MichaelEE0318/einkboard/hardware/case/stl/shell_ribbed.stl

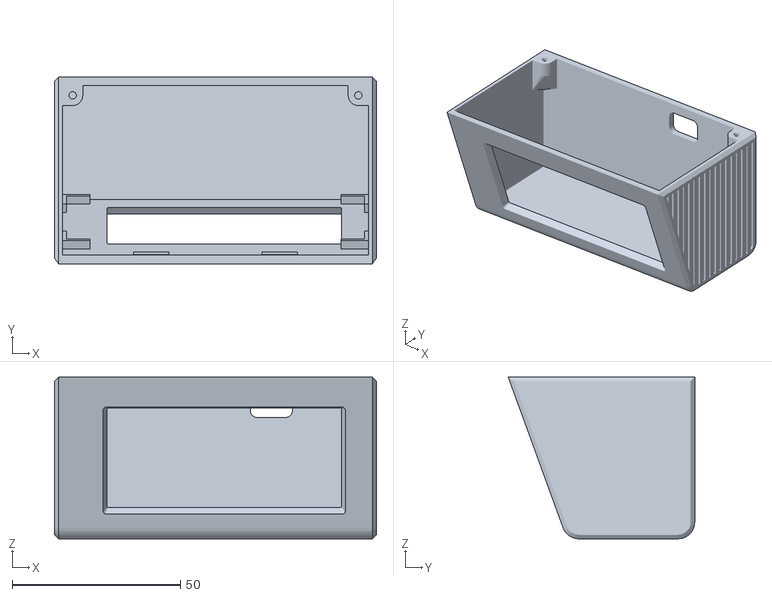
[picture p2: CAD file, 2026-11-02]
hardware/case/stl/shell_ribbed.stl
95.6 x 55.4 x 48.0
