MichaelEE0318/einkboard/hardware/case/stl/shell_retro.stl

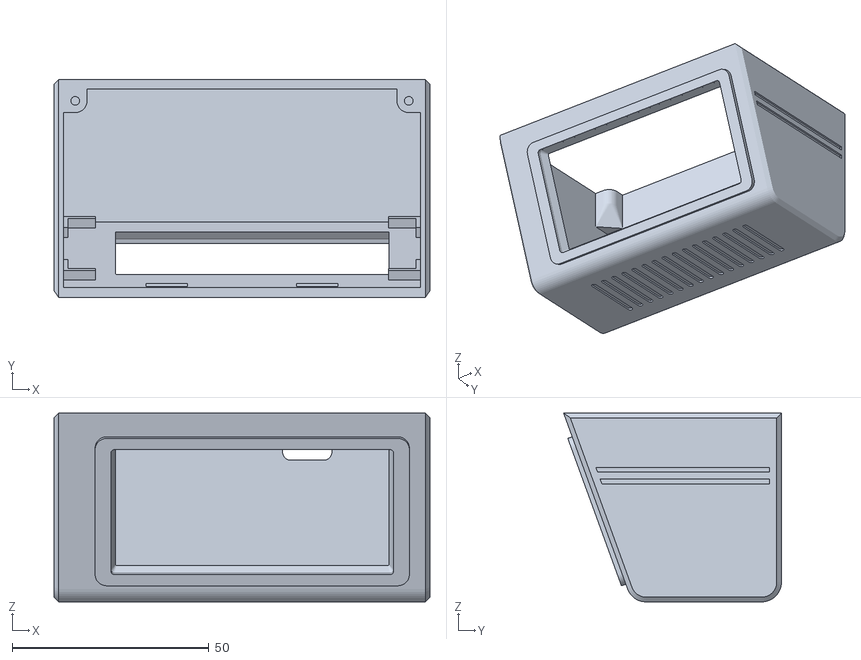
[picture p3: CAD file, 2026-11-02]
hardware/case/stl/shell_retro.stl
95.6 x 55.4 x 48.0
