MichaelEE0318/einkboard/hardware/case/stl/plate.stl

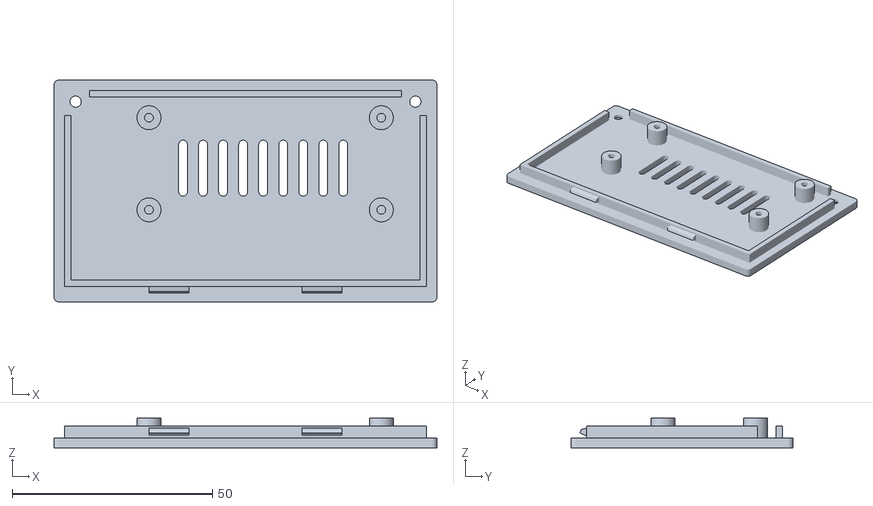
[picture p4: CAD file, 2026-11-02]
hardware/case/stl/plate.stl
95.6 x 55.4 x 7.39
