MichaelEE0318/einkboard/hardware/case/stl/eink_fit_test.stl

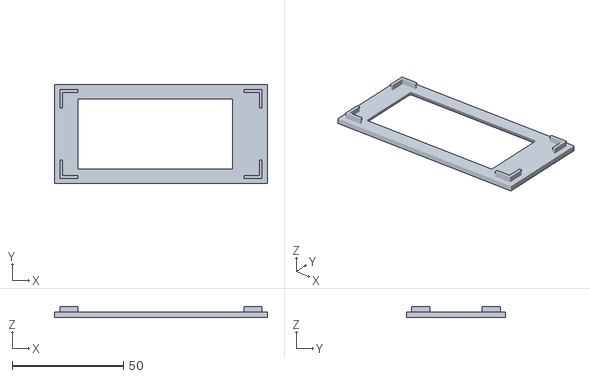
[picture p5: CAD file, 2026-11-02]
hardware/case/stl/eink_fit_test.stl
95.8 x 44.7 x 5.00
