MichaelEE0318/einkboard/hardware/case/stl/shell_clean.stl

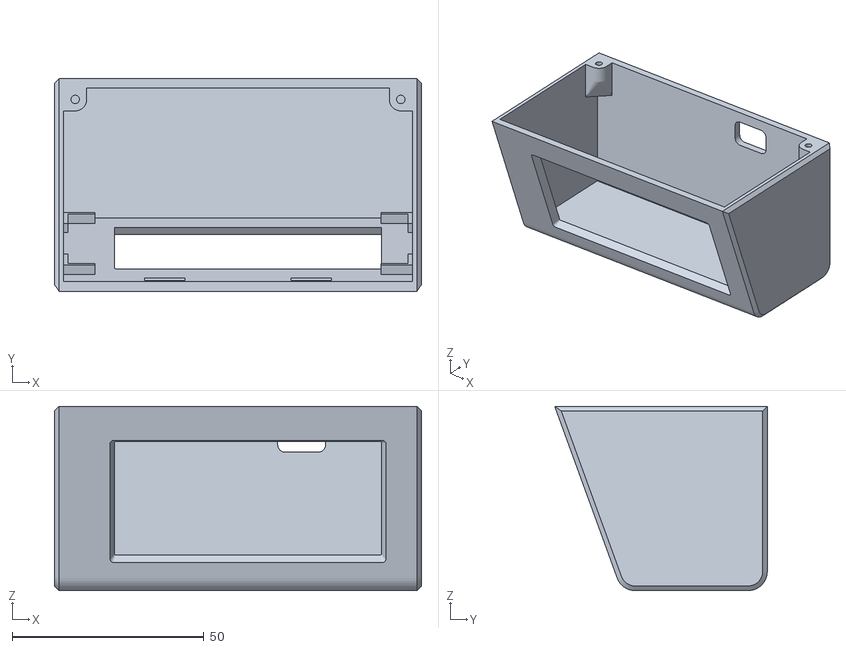
[picture p6: CAD file, 2026-11-02]
hardware/case/stl/shell_clean.stl
95.6 x 55.4 x 48.0
