MichaelEE0318/einkboard/einkboard/pages.py

"""296x128 1-bit pages. Every page is a pure function of (data, now) -> PIL image, so it can be
previewed and tested on any computer."""
import datetime as dt

from PIL import Image, ImageDraw

from . import fonts
from .sources import LIGHT

W, H = 296, 128
BLACK, WHITE = 0, 255
WEEK = "一二三四五六日"


def canvas():
    img = Image.new("1", (W, H), WHITE)
    return img, ImageDraw.Draw(img)


def cjk(size, bold=False):
    return fonts.get(size, bold=bold, cjk=True)


def num(size, bold=True):
    return fonts.get(size, bold=bold)


def fmt(v, nd=0, dash="--"):
    return dash if v is None else f"{v:,.{nd}f}"


def text_r(d, xr, y, s, font, fill=BLACK):
    d.text((xr - d.textlength(s, font=font), y), s, font=font, fill=fill)


def fit(d, s, font, width):
    """Trim with an ellipsis so CJK titles never run off the panel."""
    if d.textlength(s, font=font) <= width:
        return s
    while s and d.textlength(s + "…", font=font) > width:
        s = s[:-1]
    return s + "…"


def stale_tag(d, x, y):
    f = cjk(12, True)
    w = d.textlength("離線", font=f)
    d.rounded_rectangle([x, y, x + w + 8, y + 16], radius=4, fill=BLACK)
    d.text((x + 4, y - 1), "離線", font=f, fill=WHITE)


# ------------------------------------------------------------------ weather icons
def icon(d, kind, cx, cy, r):
    """Simple line icons drawn with primitives (no icon font needed)."""
    def sun(x, y, rr):
        d.ellipse([x - rr, y - rr, x + rr, y + rr], outline=BLACK, width=2)
        import math
        for a in range(0, 360, 45):
            c, s = math.cos(math.radians(a)), math.sin(math.radians(a))
            d.line([x + c * rr * 1.45, y + s * rr * 1.45, x + c * rr * 1.95, y + s * rr * 1.95], fill=BLACK, width=2)

    def cloud(x, y, rr, fill=WHITE):
        parts = [(x - rr * 0.55, y + rr * 0.1, rr * 0.55), (x + rr * 0.05, y - rr * 0.25, rr * 0.75),
                 (x + rr * 0.65, y + rr * 0.15, rr * 0.5)]
        for px, py, pr in parts:            # outline pass
            d.ellipse([px - pr - 2, py - pr - 2, px + pr + 2, py + pr + 2], fill=BLACK)
        d.rectangle([x - rr * 0.55, y + rr * 0.1, x + rr * 0.65, y + rr * 0.65 + 2], fill=BLACK)
        for px, py, pr in parts:            # fill pass
            d.ellipse([px - pr, py - pr, px + pr, py + pr], fill=fill)
        d.rectangle([x - rr * 0.55, y + rr * 0.1, x + rr * 0.65, y + rr * 0.65], fill=fill)

    if kind == "sun":
        sun(cx, cy, r * 0.5)
    elif kind == "partly":
        sun(cx - r * 0.3, cy - r * 0.3, r * 0.35)
        cloud(cx + r * 0.1, cy + r * 0.15, r * 0.6)
    elif kind in ("cloud", "fog"):
        cloud(cx, cy - r * 0.1, r * 0.75)
        if kind == "fog":
            for i in range(3):
                y = cy + r * 0.55 + i * 5
                d.line([cx - r * 0.7, y, cx + r * 0.7, y], fill=BLACK, width=2)
    elif kind in ("rain", "storm", "snow"):
        cloud(cx, cy - r * 0.3, r * 0.7)
        for i, dx in enumerate((-0.45, 0, 0.45)):
            x, y = cx + dx * r, cy + r * 0.5
            if kind == "snow":
                d.text((x - 4, y - 6), "*", font=num(14), fill=BLACK)
            elif kind == "storm" and i == 1:
                d.line([x + 3, y - 2, x - 3, y + 7, x + 3, y + 7, x - 2, y + 15], fill=BLACK, width=2)
            else:
                d.line([x + 2, y, x - 2, y + 9], fill=BLACK, width=2)


# ------------------------------------------------------------------ page 1: clock + weather
def page_clock(now, wx, loc_name="", stale=False):
    img, d = canvas()
    # left: clock
    hm = now.strftime("%H:%M")
    size = 56
    while size > 30 and d.textlength(hm, font=num(size)) > 146:   # 字寬依字型自動縮，不壓到右半邊
        size -= 2
    d.text((6, 26 - size * 0.58), hm, font=num(size), fill=BLACK)
    d.text((9, 60), f"{now.month}月{now.day}日  週{WEEK[now.weekday()]}", font=cjk(16, True), fill=BLACK)
    d.line([8, 86, 150, 86], fill=BLACK)
    # forecast strip (next 12 h, every 3 h)
    hours = (wx or {}).get("hours") or []
    for i, h in enumerate(hours[:4]):
        x = 8 + i * 36
        d.text((x + 3, 89), f"{h['h']:02d}時", font=cjk(10), fill=BLACK)
        d.text((x + 3, 101), f"{fmt(h['temp'])}°", font=num(12), fill=BLACK)
        d.text((x + 3, 114), f"{fmt(h['rain'])}%", font=num(10, False), fill=BLACK)

    d.line([158, 6, 158, H - 6], fill=BLACK, width=2)

    # right: weather now
    x0 = 166
    if not wx:
        d.text((x0, 50), "天氣資料載入中…", font=cjk(13), fill=BLACK)
        return img
    icon(d, wx["icon"], x0 + 22, 28, 24)
    text_r(d, W - 28, 4, f"{fmt(wx['temp'])}°", num(32))      # right-aligned, clear of the status corner
    d.text((x0, 56), fit(d, f"{loc_name} {wx['desc']}", cjk(14, True), W - x0 - 4), font=cjk(14, True), fill=BLACK)
    d.text((x0, 76), f"最高 {fmt(wx['hi'])}°  最低 {fmt(wx['lo'])}°", font=cjk(12), fill=BLACK)
    d.text((x0, 93), f"體感 {fmt(wx['feels'])}°  濕度 {fmt(wx['rh'])}%", font=cjk(12), fill=BLACK)
    # rain bar
    rain = wx.get("rain") or 0
    d.text((x0, 110), "降雨", font=cjk(11), fill=BLACK)
    bx0, bx1 = x0 + 28, W - 34
    d.rectangle([bx0, 113, bx1, 122], outline=BLACK)
    d.rectangle([bx0, 113, bx0 + (bx1 - bx0) * min(rain, 100) / 100, 122], fill=BLACK)
    text_r(d, W - 4, 109, f"{fmt(rain)}%", num(12))
    return img


# ------------------------------------------------------------------ page 2: Taipower
def page_power(now, pw, stale=False):
    img, d = canvas()
    d.text((6, 1), "台電供電資訊", font=cjk(15, True), fill=BLACK)
    if not pw:
        d.text((6, 50), "台電資料載入中…", font=cjk(14), fill=BLACK)
        return img
    pub = pw.get("publish") or ""
    text_r(d, W - 28, 4, (pub[-5:] if len(pub) >= 5 else pub) + " 更新", cjk(10))

    # left: today's peak reserve forecast + light
    zh, note = LIGHT.get(pw["light"], ("--", ""))
    d.text((6, 24), "今日尖峰備轉容量率", font=cjk(11), fill=BLACK)
    d.text((4, 34), f"{fmt(pw['fore_rate'], 1)}", font=num(40), fill=BLACK)
    rx = 6 + d.textlength(fmt(pw["fore_rate"], 1), font=num(40))
    d.text((rx + 2, 55), "%", font=num(16), fill=BLACK)
    # light badge: filled = needs attention (non-green)
    lf = cjk(13, True)
    bw = d.textlength(f"{zh} {note}", font=lf) + 12
    alert = pw["light"] not in ("green", None)
    d.rounded_rectangle([6, 84, 6 + bw, 102], radius=9, fill=BLACK if alert else WHITE, outline=BLACK, width=2)
    d.text((12, 83), f"{zh} {note}", font=lf, fill=WHITE if alert else BLACK)
    resv = pw.get("fore_resv")
    sub = f"備轉 {fmt(resv)} 萬瓩" + (f"  {pw['fore_hours']}" if pw.get("fore_hours") else "")
    d.text((6, 107), fit(d, sub, cjk(10), 146), font=cjk(10), fill=BLACK)

    d.line([158, 24, 158, H - 6], fill=BLACK, width=2)

    # right: real-time
    x0 = 166
    d.text((x0, 24), "目前用電", font=cjk(11), fill=BLACK)
    d.text((x0, 36), fmt(pw["load"], 0), font=num(24), fill=BLACK)
    text_r(d, W - 6, 46, "萬瓩", cjk(11))
    d.text((x0, 66), f"供電能力 {fmt(pw['cap'], 0)} 萬瓩", font=cjk(11), fill=BLACK)
    util = pw.get("util")
    d.text((x0, 84), "使用率", font=cjk(11), fill=BLACK)
    text_r(d, W - 6, 82, f"{fmt(util, 1)}%", num(14))
    bx0, bx1 = x0, W - 6
    d.rectangle([bx0, 102, bx1, 112], outline=BLACK)
    if util is not None:
        d.rectangle([bx0, 102, bx0 + (bx1 - bx0) * min(util, 100) / 100, 112], fill=BLACK)
    for t in (90, 94):                 # 參考刻度：使用率 90% / 94% ≈ 備轉 10% / 6%
        tx = bx0 + (bx1 - bx0) * t / 100
        d.polygon([(tx - 3, 97), (tx + 3, 97), (tx, 101)], fill=BLACK)
    if pw.get("yday_rate") is not None:
        d.text((x0, 115), f"昨日尖峰備轉 {fmt(pw['yday_rate'], 1)}%", font=cjk(9), fill=BLACK)
    return img


# ------------------------------------------------------------------ page 3: stocks + FX
FX_NAME = {"USD": "美元", "JPY": "日圓", "VND": "越南盾", "EUR": "歐元", "CNY": "人民幣", "HKD": "港幣",
           "KRW": "韓元", "GBP": "英鎊", "AUD": "澳幣", "SGD": "新幣", "THB": "泰銖"}


def chg_abs_str(v):
    """Size of the move without sign: 1173 / 20 / 4.2 / 0.65 (no thousands comma: keeps a 4-digit index
    move narrow enough for the larger font)."""
    if v is None:
        return "--"
    a = abs(v)
    return f"{a:.0f}" if a >= 100 else f"{a:.2f}".rstrip("0").rstrip(".")


def price_str(v):
    if v is None:
        return "--"
    if v >= 1000:
        return f"{v:,.0f}"
    return f"{v:,.2f}".rstrip("0").rstrip(".")      # 412.5 / 189.85 / 23.1（ETF 跳動單位 0.05）


def fx_str(code, rate):
    """TWD per unit; tiny currencies (VND, KRW...) are shown per 1,000 / 10,000 units."""
    if rate is None:
        return code, "--"
    if rate < 0.01:
        return f"{code}/萬", f"{rate * 10000:.2f}"
    if rate < 0.1:
        return f"{code}/千", f"{rate * 1000:.2f}"
    return code, f"{rate:.4f}" if rate < 1 else f"{rate:.2f}"


def sparkline(d, pts, x0, y0, x1, y1, prev=None):
    """Today's prices (minute_of_day, price) between 09:00 and 13:30; dotted line = previous close."""
    if not pts or len(pts) < 2 or pts[-1][0] - pts[0][0] < 15:
        return                                  # under 15 min of data (e.g. just restarted): skip, it looks broken
    lo = min(p for _, p in pts)
    hi = max(p for _, p in pts)
    if prev:
        lo, hi = min(lo, prev), max(hi, prev)
    if hi - lo < 1e-9:
        hi = lo + 1
    t0, t1 = 9 * 60, 13 * 60 + 30
    xy = lambda m, p: (x0 + (x1 - x0) * (min(max(m, t0), t1) - t0) / (t1 - t0), y1 - (y1 - y0) * (p - lo) / (hi - lo))
    if prev:
        py = xy(t0, prev)[1]
        for x in range(int(x0), int(x1), 3):
            d.point([x, py], fill=BLACK)
    d.line([xy(m, p) for m, p in pts], fill=BLACK, width=1)


def page_market(now, mk, stale=False):
    img, d = canvas()
    d.text((6, 1), "台股．匯率", font=cjk(15, True), fill=BLACK)
    if not mk:
        d.text((6, 50), "行情資料載入中…", font=cjk(14), fill=BLACK)
        return img
    quotes = list(mk["quotes"].values())
    t = max((q.get("time") or "" for q in quotes), default="")
    src = mk.get("src", "mis")
    if mk.get("open"):
        status = f"盤中 {t[:5]}"
    elif src == "close" or (quotes and all(q.get("date") for q in quotes)):
        day = max((q.get("date") or "" for q in quotes), default="")
        status = f"收盤 {int(day[5:7])}/{int(day[8:10])}" if len(day) == 10 else "收盤"
    else:
        status = "收盤" if quotes else ""
    if status:
        f = cjk(11, True)
        w = d.textlength(status, font=f)
        if mk.get("open"):
            d.rounded_rectangle([W - w - 38, 3, W - 28, 18], radius=7, fill=BLACK)
            d.text((W - w - 33, 2), status, font=f, fill=WHITE)
        else:
            text_r(d, W - 30, 3, status, f)
    d.line([6, 21, W - 6, 21], fill=BLACK)

    rows = quotes[:4]
    fx = [(c, r) for c, r in (mk.get("fx") or {}).items()][:3]
    area = (92 if fx else H - 2) - 24
    rh = min(24, area // max(1, len(rows)))
    # change box: "▼1,173" left + "2.53%" right; one font size for every row (the largest that fits all)
    bx0, bx1 = W - 82, W - 4                          # 78 px: "▼1173  2.53%" fits at size 10
    labels = []
    for q in rows:
        pct, chg = q.get("pct"), q.get("chg")
        arrow = "▲" if (pct or 0) > 0 else "▼" if (pct or 0) < 0 else ""
        labels.append((f"{arrow}{chg_abs_str(chg)}", "--" if pct is None else f"{abs(pct):.2f}%"))
    fsize = 10
    for size in ((11, 10, 9, 8) if rh >= 21 else (10, 9, 8)):
        f = cjk(size, True)
        if all(d.textlength(a, font=f) + d.textlength(b, font=f) + 5 <= bx1 - bx0 - 6 for a, b in labels):
            fsize = size
            break
    fbox = cjk(fsize, True)
    y = 24
    for q, (s1, s2) in zip(rows, labels):
        name = fit(d, q["name"] or q["code"], cjk(13, True), 72)
        d.text((6, y - 1), name, font=cjk(13, True), fill=BLACK)
        d.text((6 + d.textlength(name, font=cjk(13, True)) + 3, y + 3), q["code"], font=num(9, False), fill=BLACK)
        sparkline(d, (mk.get("history") or {}).get(q["code"]), 110, y + 2, 146, y + rh - 5, q.get("prev"))
        text_r(d, bx0 - 5, y, price_str(q["price"]), num(14))
        up = (q.get("pct") or 0) > 0
        by1 = y + rh - 3
        if up:                             # 漲：實心（台灣紅色的位置）
            d.rounded_rectangle([bx0, y, bx1, by1], radius=3, fill=BLACK)
        else:                              # 跌 / 平：空心
            d.rounded_rectangle([bx0, y, bx1, by1], radius=3, outline=BLACK)
        fg = WHITE if up else BLACK
        l, t, r, b = d.textbbox((0, 0), "▼0", font=fbox)
        ty = (y + by1) / 2 - (t + b) / 2
        d.text((bx0 + 3, ty), s1, font=fbox, fill=fg)
        text_r(d, bx1 - 3, ty, s2, fbox, fill=fg)
        y += rh
    if not rows:
        d.text((6, 40), "在 config.yaml 的 market.stocks 加股票代號", font=cjk(12), fill=BLACK)

    if fx:
        d.line([6, 94, W - 6, 94], fill=BLACK)
        cw = (W - 12) / len(fx)
        for i, (code, rate) in enumerate(fx):
            x = 6 + i * cw
            label, val = fx_str(code, rate)
            d.text((x, 97), FX_NAME.get(code, code), font=cjk(10), fill=BLACK)
            d.text((x + d.textlength(FX_NAME.get(code, code), font=cjk(10)) + 3, 97), label, font=cjk(9), fill=BLACK)
            d.text((x, 109), val, font=num(14), fill=BLACK)
            if i:
                d.line([x - 5, 98, x - 5, 124], fill=BLACK)
    return img


# ------------------------------------------------------------------ status signs (manual: 出差中 / 下班了 / 暫離)
STATUS_KINDS = {"trip": "出差中", "off": "下班了", "away": "暫離", "custom": "字卡"}


def _icon_plane(d, cx, cy, s=1.0):
    """Side-view airliner, nose to the right."""
    P = lambda pts: [(cx + x * s, cy + y * s) for x, y in pts]
    d.rounded_rectangle([cx - 34 * s, cy - 5 * s, cx + 30 * s, cy + 5 * s], radius=5 * s, fill=BLACK)   # fuselage
    d.polygon(P([(36, 0), (28, -5), (28, 5)]), fill=BLACK)                                              # nose
    d.polygon(P([(-6, 2), (8, 2), (-10, 30), (-20, 30)]), fill=BLACK)                                   # near wing
    d.polygon(P([(-2, -2), (8, -2), (-8, -20), (-16, -20)]), fill=BLACK)                                # far wing
    d.polygon(P([(-34, -2), (-24, -2), (-34, -20), (-40, -20)]), fill=BLACK)                            # tail fin
    for i in range(5):                                                                                   # windows
        x = cx + (-20 + i * 9) * s
        d.rectangle([x, cy - 2 * s, x + 4 * s, cy], fill=WHITE)


def _icon_moon(d, cx, cy, r=26):
    d.ellipse([cx - r, cy - r, cx + r, cy + r], fill=BLACK)
    d.ellipse([cx - r + 14, cy - r - 6, cx + r + 14, cy + r - 6], fill=WHITE)                          # carve crescent
    for sx, sy, k in ((cx + 24, cy - 22, 4), (cx + 30, cy + 8, 3), (cx + 8, cy + 26, 2)):               # stars
        d.line([sx - k, sy, sx + k, sy], fill=BLACK, width=2)
        d.line([sx, sy - k, sx, sy + k], fill=BLACK, width=2)


def _icon_cup(d, cx, cy):
    d.rounded_rectangle([cx - 22, cy - 10, cx + 14, cy + 26], radius=6, fill=BLACK)                    # cup
    d.ellipse([cx + 6, cy - 4, cx + 30, cy + 18], outline=BLACK, width=5)                              # handle
    d.rectangle([cx - 30, cy + 28, cx + 22, cy + 32], fill=BLACK)                                      # saucer
    for x in (cx - 12, cx - 3, cx + 6):                                                                 # steam
        d.arc([x - 4, cy - 34, x + 4, cy - 22], 90, 270, fill=BLACK, width=2)
        d.arc([x - 4, cy - 24, x + 4, cy - 12], 270, 90, fill=BLACK, width=2)


# ------------------------------------------------------------------ 字卡圖示（左邊 98 px 的格子，中心約 (48, 64)）
def _icon_people(d, cx, cy):                    # 開會：兩個人＋桌子
    for dx, r in ((-14, 9), (14, 9)):
        d.ellipse([cx + dx - r, cy - 30, cx + dx + r, cy - 30 + 2 * r], fill=BLACK)
        d.pieslice([cx + dx - 16, cy - 8, cx + dx + 16, cy + 24], 180, 360, fill=BLACK)
    d.rectangle([cx - 36, cy + 10, cx + 36, cy + 15], fill=BLACK)
    d.rectangle([cx - 30, cy + 15, cx - 26, cy + 32], fill=BLACK)
    d.rectangle([cx + 26, cy + 15, cx + 30, cy + 32], fill=BLACK)


def _icon_phone(d, cx, cy):                     # 電話中／講電話
    d.rounded_rectangle([cx - 16, cy - 32, cx + 16, cy + 32], radius=6, fill=BLACK)
    d.rectangle([cx - 11, cy - 23, cx + 11, cy + 18], fill=WHITE)
    d.ellipse([cx - 3, cy + 22, cx + 3, cy + 28], fill=WHITE)
    for r in (8, 15):                           # sound waves
        d.arc([cx + 18 - r, cy - 30 - r, cx + 18 + r, cy - 30 + r], 300, 30, fill=BLACK, width=3)


def _icon_clock(d, cx, cy):                     # 稍等／時間
    d.ellipse([cx - 32, cy - 32, cx + 32, cy + 32], outline=BLACK, width=5)
    for k in range(12):
        import math
        a = math.radians(k * 30)
        r1 = 23 if k % 3 else 20
        d.line([cx + r1 * math.sin(a), cy - r1 * math.cos(a), cx + 26 * math.sin(a), cy - 26 * math.cos(a)],
               fill=BLACK, width=2)
    d.line([cx, cy, cx, cy - 18], fill=BLACK, width=4)
    d.line([cx, cy, cx + 13, cy + 7], fill=BLACK, width=4)
    d.ellipse([cx - 4, cy - 4, cx + 4, cy + 4], fill=BLACK)


def _icon_house(d, cx, cy):                     # 在家工作
    d.polygon([(cx - 38, cy - 2), (cx, cy - 36), (cx + 38, cy - 2)], fill=BLACK)
    d.rectangle([cx - 28, cy - 4, cx + 28, cy + 32], fill=BLACK)
    d.rectangle([cx - 8, cy + 10, cx + 8, cy + 32], fill=WHITE)
    d.rectangle([cx + 14, cy + 4, cx + 22, cy + 12], fill=WHITE)
    d.rectangle([cx + 18, cy - 32, cx + 26, cy - 16], fill=BLACK)   # chimney


def _icon_bowl(d, cx, cy):                      # 用餐／午休
    d.chord([cx - 34, cy - 22, cx + 34, cy + 36], 0, 180, fill=BLACK)
    d.rectangle([cx - 14, cy + 30, cx + 14, cy + 34], fill=BLACK)
    d.line([cx + 4, cy - 34, cx + 30, cy + 4], fill=BLACK, width=3)   # chopsticks
    d.line([cx + 14, cy - 36, cx + 36, cy], fill=BLACK, width=3)
    for x in (cx - 16, cx - 4):                 # steam
        d.arc([x - 4, cy - 26, x + 4, cy - 14], 90, 270, fill=BLACK, width=2)
        d.arc([x - 4, cy - 16, x + 4, cy - 4], 270, 90, fill=BLACK, width=2)


def _icon_car(d, cx, cy):                       # 外出／開車
    d.polygon([(cx - 22, cy - 8), (cx - 12, cy - 26), (cx + 14, cy - 26), (cx + 26, cy - 8)], fill=BLACK)
    d.polygon([(cx - 15, cy - 9), (cx - 9, cy - 21), (cx - 1, cy - 21), (cx - 1, cy - 9)], fill=WHITE)
    d.polygon([(cx + 3, cy - 9), (cx + 3, cy - 21), (cx + 12, cy - 21), (cx + 19, cy - 9)], fill=WHITE)
    d.rounded_rectangle([cx - 38, cy - 10, cx + 38, cy + 14], radius=7, fill=BLACK)
    for x in (cx - 22, cx + 22):
        d.ellipse([x - 11, cy + 2, x + 11, cy + 24], fill=BLACK)
        d.ellipse([x - 5, cy + 8, x + 5, cy + 18], fill=WHITE)
    d.rectangle([cx + 30, cy - 4, cx + 36, cy + 1], fill=WHITE)   # headlight


def _icon_helmet(d, cx, cy):                    # 案場／工地
    d.pieslice([cx - 32, cy - 30, cx + 32, cy + 30], 180, 360, fill=BLACK)
    d.rounded_rectangle([cx - 42, cy - 2, cx + 42, cy + 8], radius=4, fill=BLACK)
    d.rectangle([cx - 4, cy - 30, cx + 4, cy - 2], fill=WHITE)   # ridge
    d.rectangle([cx - 2, cy - 28, cx + 2, cy - 4], fill=BLACK)


def _icon_bolt(d, cx, cy):                      # 電力／儲能
    d.polygon([(cx + 8, cy - 38), (cx - 22, cy + 6), (cx - 2, cy + 6), (cx - 10, cy + 38),
               (cx + 22, cy - 8), (cx + 2, cy - 8)], fill=BLACK)


def _icon_battery(d, cx, cy):                   # 充電／儲能系統
    d.rounded_rectangle([cx - 20, cy - 30, cx + 20, cy + 34], radius=5, outline=BLACK, width=5)
    d.rectangle([cx - 9, cy - 37, cx + 9, cy - 30], fill=BLACK)
    for i in range(3):
        y = cy + 22 - i * 16
        d.rectangle([cx - 12, y - 6, cx + 12, y + 6], fill=BLACK)


def _icon_doc(d, cx, cy):                       # 文件／專心寫東西
    d.polygon([(cx - 24, cy - 34), (cx + 12, cy - 34), (cx + 26, cy - 20), (cx + 26, cy + 34), (cx - 24, cy + 34)],
              outline=BLACK, width=4)
    d.polygon([(cx + 12, cy - 34), (cx + 12, cy - 20), (cx + 26, cy - 20)], fill=BLACK)
    for i in range(4):
        y = cy - 12 + i * 11
        d.line([cx - 14, y, cx + (16 if i < 3 else 2), y], fill=BLACK, width=3)


def _icon_cross(d, cx, cy):                     # 看醫生／請假
    d.rounded_rectangle([cx - 32, cy - 32, cx + 32, cy + 32], radius=10, fill=BLACK)
    d.rectangle([cx - 7, cy - 22, cx + 7, cy + 22], fill=WHITE)
    d.rectangle([cx - 22, cy - 7, cx + 22, cy + 7], fill=WHITE)


def _icon_check(d, cx, cy):                     # 完成／OK
    d.ellipse([cx - 34, cy - 34, cx + 34, cy + 34], fill=BLACK)
    d.line([(cx - 18, cy + 1), (cx - 5, cy + 15), (cx + 20, cy - 13)], fill=WHITE, width=9, joint="curve")


def _icon_bang(d, cx, cy):                      # 注意／請勿打擾
    d.polygon([(cx, cy - 36), (cx + 38, cy + 30), (cx - 38, cy + 30)], fill=BLACK)
    d.rectangle([cx - 4, cy - 14, cx + 4, cy + 12], fill=WHITE)
    d.rectangle([cx - 4, cy + 17, cx + 4, cy + 24], fill=WHITE)


def _icon_heart(d, cx, cy):
    d.ellipse([cx - 34, cy - 28, cx + 2, cy + 6], fill=BLACK)
    d.ellipse([cx - 2, cy - 28, cx + 34, cy + 6], fill=BLACK)
    d.polygon([(cx - 33, cy - 6), (cx + 33, cy - 6), (cx, cy + 32)], fill=BLACK)


ICONS = {   # key: (中文名, 畫法)；左格中心 (48, 64)
    "meeting": ("開會", lambda d: _icon_people(d, 48, 66)),
    "phone": ("電話", lambda d: _icon_phone(d, 46, 66)),
    "clock": ("時鐘", lambda d: _icon_clock(d, 48, 64)),
    "cup": ("咖啡", lambda d: _icon_cup(d, 46, 64)),
    "bowl": ("用餐", lambda d: _icon_bowl(d, 46, 62)),
    "house": ("在家", lambda d: _icon_house(d, 48, 64)),
    "car": ("外出", lambda d: _icon_car(d, 48, 62)),
    "plane": ("飛機", lambda d: _icon_plane(d, 50, 58, 1.0)),
    "helmet": ("案場", lambda d: _icon_helmet(d, 48, 70)),
    "bolt": ("閃電", lambda d: _icon_bolt(d, 48, 64)),
    "battery": ("電池", lambda d: _icon_battery(d, 48, 64)),
    "doc": ("文件", lambda d: _icon_doc(d, 48, 64)),
    "cross": ("醫療", lambda d: _icon_cross(d, 48, 64)),
    "moon": ("月亮", lambda d: _icon_moon(d, 48, 62)),
    "check": ("完成", lambda d: _icon_check(d, 48, 64)),
    "bang": ("注意", lambda d: _icon_bang(d, 48, 62)),
    "heart": ("愛心", lambda d: _icon_heart(d, 48, 64)),
}
ICON_BOX = (6, 8, 92, H - 8)                   # 自訂上傳圖示的可用範圍（86×112）


def _status_frame(d, title, icon):
    d.rectangle([0, 0, W - 1, H - 1], outline=BLACK, width=2)
    d.line([98, 10, 98, H - 10], fill=BLACK, width=1)
    icon()
    d.text((108, 6), title, font=cjk(30, True), fill=BLACK)


def _date_zh(day):
    return f"{day.month}/{day.day}（{WEEK[day.weekday()]}）"


def page_trip(now, info):
    """出差中: where, back on which day (with a countdown), how to reach me."""
    img, d = canvas()
    _status_frame(d, "出差中", lambda: _icon_plane(d, 50, 58, 1.0))
    place = (info.get("place") or "").strip()
    if place:
        d.text((110, 46), fit(d, place, cjk(16, True), W - 118), font=cjk(16, True), fill=BLACK)
    back = info.get("back")
    y = 72
    if back:
        try:
            day = dt.date.fromisoformat(back)
            left = (day - now.date()).days
            tag = "今天回來" if left == 0 else (f"還有 {left} 天" if left > 0 else "已過預定回程")
            f = cjk(13, True)
            w = d.textlength(tag, font=f)
            d.rounded_rectangle([W - w - 18, y + 1, W - 8, y + 19], radius=9, fill=BLACK)
            d.text((W - w - 13, y + 1), tag, font=f, fill=WHITE)
            d.text((110, y), fit(d, f"{_date_zh(day)} 回來", cjk(13), W - w - 132), font=cjk(13), fill=BLACK)
        except ValueError:
            pass
    note = (info.get("note") or "").strip()
    if note:
        d.text((110, H - 22), fit(d, note, cjk(11), W - 118), font=cjk(11), fill=BLACK)
    return img


def _next_workday_label(now):
    """When I'm back, seen from `now`: Mon–Thu evening -> 明天, Fri/Sat -> 下週一, Sun -> 明天;
    before 06:00 on a weekday it's still the same working day -> 今天."""
    wd = now.weekday()
    if now.hour < 6 and wd <= 4:
        return "今天"
    if wd in (4, 5):
        return "下週一"
    return "明天"


def page_off(now, info, wx=None):
    """下班了: when I'm back, and tomorrow's weather."""
    img, d = canvas()
    _status_frame(d, "下班了", lambda: _icon_moon(d, 48, 62))
    back = (info.get("back") or "09:00").strip()
    d.text((110, 48), f"{_next_workday_label(now)} {back} 見", font=cjk(18, True), fill=BLACK)
    note = (info.get("note") or "").strip()
    if note:
        d.text((110, 76), fit(d, note, cjk(12), W - 118), font=cjk(12), fill=BLACK)
    t = (wx or {}).get("tomorrow")
    if t:
        d.line([108, H - 26, W - 8, H - 26], fill=BLACK)
        d.text((110, H - 23), f"明天 {t['desc']}  {fmt(t['lo'])}°～{fmt(t['hi'])}°  降雨 {fmt(t.get('rain'))}%",
               font=cjk(11), fill=BLACK)
    return img


def page_away(now, info):
    """暫離: back at what time + an optional note, centred in the right panel. Static on purpose."""
    img, d = canvas()
    d.rectangle([0, 0, W - 1, H - 1], outline=BLACK, width=2)
    d.line([98, 10, 98, H - 10], fill=BLACK, width=1)
    _icon_cup(d, 46, 64)
    back = (info.get("back") or "").strip()
    note = (info.get("note") or "").strip()
    lines = [("暫離", cjk(30, True)), (f"預計 {back} 回來" if back else "馬上回來", cjk(18, True))]
    if note:
        lines.append((fit(d, note, cjk(14), W - 118), cjk(14)))
    gap = 6
    boxes = [d.textbbox((0, 0), t, font=f) for t, f in lines]
    total = sum(b[3] - b[1] for b in boxes) + gap * (len(lines) - 1)
    x_mid, y = (99 + W - 2) / 2, (H - total) / 2               # centre of the right panel
    for (t, f), b in zip(lines, boxes):
        d.text((x_mid - (b[2] - b[0]) / 2 - b[0], y - b[1]), t, font=f, fill=BLACK)
        y += b[3] - b[1] + gap
    return img


# ------------------------------------------------------------------ 字卡（完全手填）
CARD_MAX_LINES, CARD_MAX_CHARS = 5, 80


def _wrap(d, line, font, width):
    """Break one line to fit `width` (CJK: any character; Latin: prefer spaces)."""
    out, cur = [], ""
    for ch in line:
        if d.textlength(cur + ch, font=font) <= width or not cur:
            cur += ch
            continue
        cut = cur.rfind(" ")
        if cut > 0 and cur[cut + 1:].isascii() and ch != " ":
            out.append(cur[:cut]); cur = cur[cut + 1:] + ch
        else:
            out.append(cur.rstrip()); cur = ch.lstrip()
    out.append(cur)
    return out


def card_layout(d, text, title=False, bold=False, box=(8, 16, W - 8, H - 6)):
    """Largest font that fits the box. Lines are kept as typed when possible; only wrap when the
    unwrapped text would end up smaller than 18 px. Returns [(text, font, height)], gap."""
    lines = [ln.strip() for ln in text.split("\n")]
    while lines and not lines[-1]:
        lines.pop()
    while lines and not lines[0]:
        lines.pop(0)
    if not lines:
        return [], 0
    bw, bh = box[2] - box[0], box[3] - box[1]

    def build(size, wrap):
        rows = []
        for i, ln in enumerate(lines):
            big = title and i == 0 and len(lines) > 1
            f = cjk(min(96, round(size * 1.45)) if big else size, bold or big)
            parts = _wrap(d, ln, f, bw) if wrap else [ln]
            for part in parts:
                b = d.textbbox((0, 0), "國Ag", font=f)
                rows.append((part, f, b[3] - b[1]))
        gap = max(2, size // 5)
        total = sum(r[2] for r in rows) + gap * (len(rows) - 1)
        widest = max(d.textlength(r[0], font=r[1]) for r in rows)
        return rows, gap, total <= bh and widest <= bw

    for wrap in (False, True):
        for size in range(72, 9, -1):
            rows, gap, ok = build(size, wrap)
            if ok and (wrap or size >= 18):
                return rows, gap
    return build(10, True)[:2]


def missing_glyphs(text, bold=False):
    """Characters the panel font can't draw (emoji etc.) — they would show as an empty box."""
    def shape(f, ch):
        im = Image.new("1", (32, 32), 0)
        ImageDraw.Draw(im).text((4, 2), ch, font=f, fill=1)
        return im.tobytes()

    out = []
    for f in {cjk(20, bold), cjk(20, True)}:
        tofu = shape(f, "\uFFFF")
        for ch in set(text):
            if not ch.isspace() and ch not in out and shape(f, ch) == tofu:
                out.append(ch)
    return sorted(out)


def decode_icon(b64):
    """Uploaded icon (base64 PNG/JPEG) -> grayscale image that fits the left panel, or None."""
    import base64
    import io
    try:
        im = Image.open(io.BytesIO(base64.b64decode(b64.split(",")[-1], validate=True)))
        im.load()
    except Exception:
        return None
    if im.mode in ("RGBA", "LA", "P"):
        im = im.convert("RGBA")
        bg = Image.new("RGBA", im.size, (255, 255, 255, 255))
        im = Image.alpha_composite(bg, im)
    im = im.convert("L")
    bw, bh = ICON_BOX[2] - ICON_BOX[0], ICON_BOX[3] - ICON_BOX[1]
    im.thumbnail((bw, bh), Image.LANCZOS)
    return im


def icon_bitmap(gray, dither=False, threshold=128):
    """Grayscale -> 1-bit: plain threshold for logos/line art, Floyd–Steinberg for photos."""
    from PIL import ImageOps
    g = ImageOps.autocontrast(gray, cutoff=1)
    if dither:
        return g.convert("1")
    return g.point(lambda v: 255 if v >= threshold else 0).convert("1", dither=Image.Dither.NONE)


def _draw_card_icon(img, d, info):
    key = info.get("icon") or ""
    if key == "upload" and info.get("icon_png"):
        g = decode_icon(info["icon_png"])
        if g is None:
            return
        bmp = icon_bitmap(g, bool(info.get("icon_dither")))
        x0, y0, x1, y1 = ICON_BOX
        img.paste(bmp, (int(x0 + (x1 - x0 - bmp.width) / 2), int(y0 + (y1 - y0 - bmp.height) / 2)))
    elif key in ICONS:
        ICONS[key][1](d)


def _draw_rows(d, rows, gap, box, left, ink=BLACK):
    total = sum(r[2] for r in rows) + gap * (len(rows) - 1)
    y = box[1] + (box[3] - box[1] - total) / 2
    for t, f, h in rows:
        top = d.textbbox((0, 0), "國Ag", font=f)[1]
        w = d.textlength(t, font=f)
        x = box[0] if left else (box[0] + box[2] - w) / 2
        d.text((x, y - top), t, font=f, fill=ink)
        y += h + gap


def page_card(now, info):
    """字卡。layout=sign：跟其他狀態牌一樣（左邊圖示、右邊文字）；layout=free：整面都是字。
    選項：置中／靠左、第一行放大、粗體、外框（free）、黑底白字。"""
    img, d = canvas()
    text = info.get("text") or ""
    left = info.get("align") == "left"
    if info.get("layout") == "sign":
        d.rectangle([0, 0, W - 1, H - 1], outline=BLACK, width=2)
        d.line([98, 10, 98, H - 10], fill=BLACK, width=1)
        _draw_card_icon(img, d, info)
        box = (106, 16, W - 8, H - 6)                     # top 16: keep clear of the Wi-Fi icon
        rows, gap = card_layout(d, text, info.get("title", True), bool(info.get("bold")), box)
        if not rows:
            d.text(((box[0] + box[2]) / 2, H / 2), "（還沒有輸入文字）", font=cjk(12), fill=BLACK, anchor="mm")
        _draw_rows(d, rows, gap, box, left)
    else:
        if info.get("border"):
            d.rectangle([2, 2, W - 3, H - 3], outline=BLACK, width=2)
        box = (12, 16, W - 12, H - 10) if info.get("border") else (8, 16, W - 8, H - 6)
        rows, gap = card_layout(d, text, bool(info.get("title")), bool(info.get("bold")), box)
        if not rows:
            d.text((W / 2, H / 2), "（還沒有輸入文字）", font=cjk(14), fill=BLACK, anchor="mm")
        _draw_rows(d, rows, gap, box, left)
    if info.get("invert"):
        from PIL import ImageOps
        img = ImageOps.invert(img.convert("L")).convert("1")
    return img


def page_status(now, info, wx=None):
    kind = info.get("kind")
    if kind == "custom":
        return page_card(now, info)
    if kind == "trip":
        return page_trip(now, info)
    if kind == "off":
        return page_off(now, info, wx)
    return page_away(now, info)


# ------------------------------------------------------------------ Wi-Fi indicator (every page, top-right)
def draw_wifi(img, bars, connected=True, internet=True, stale=False):
    """14x12 px Wi-Fi fan in the top-right corner.
    bars 1-3 = signal; '!' = Wi-Fi up but no internet; slash = not connected."""
    d = ImageDraw.Draw(img)
    x0, y0 = W - 18, 2                      # icon box: x0..x0+14, y0..y0+12
    cx, cy = x0 + 7, y0 + 11                # fan centre (bottom middle)
    d.rectangle([x0 - 1, y0 - 1, x0 + 15, y0 + 13], fill=WHITE)
    d.ellipse([cx - 1, cy - 2, cx + 1, cy], fill=BLACK)                       # dot
    shown = bars if connected else 3
    for i, r in enumerate((4, 7, 10), start=1):
        box = [cx - r, cy - r, cx + r, cy + r]
        if i <= shown:
            d.arc(box, 225, 315, fill=BLACK, width=2)
        else:                                   # missing bar: thin dotted hint so the icon keeps its shape
            for a in range(228, 315, 14):
                import math
                px, py = cx + r * math.cos(math.radians(a)), cy + r * math.sin(math.radians(a))
                d.point([px, py], fill=BLACK)
    if not connected:                           # slash through the fan
        d.line([x0, y0 + 1, x0 + 14, y0 + 12], fill=WHITE, width=4)
        d.line([x0, y0 + 1, x0 + 14, y0 + 12], fill=BLACK, width=2)
    elif not internet or stale:                 # '!' to the left of the fan: no internet / this page's data is old
        d.rectangle([x0 - 6, y0 - 1, x0 - 2, y0 + 13], fill=WHITE)
        d.rectangle([x0 - 5, y0, x0 - 3, y0 + 7], fill=BLACK)
        d.rectangle([x0 - 5, y0 + 10, x0 - 3, y0 + 12], fill=BLACK)
    return img


# ------------------------------------------------------------------ night / boot
def page_night(now, wx=None):
    img, d = canvas()
    d.text((W // 2 - 40, 18), "晚安", font=cjk(36, True), fill=BLACK)
    msg = f"{now.month}/{now.day} 週{WEEK[now.weekday()]}"
    if wx and wx.get("tomorrow"):
        t = wx["tomorrow"]
        msg += f"   明天 {t['desc']} {fmt(t['lo'])}°~{fmt(t['hi'])}°"
    d.text((W // 2 - d.textlength(msg, font=cjk(13)) / 2, 76), msg, font=cjk(13), fill=BLACK)
    d.text((W // 2 - d.textlength("夜間暫停更新", font=cjk(10)) / 2, 104), "夜間暫停更新", font=cjk(10), fill=BLACK)
    return img


# ------------------------------------------------------------------ Wi-Fi 開箱設定
def draw_qr(img, text, x, y, size):
    """QR Code，盡量用整數倍放大（1-bit 才會銳利）。沒有 qrcode 套件就畫提示框。"""
    d = ImageDraw.Draw(img)
    try:
        import qrcode
        q = qrcode.QRCode(border=0, error_correction=qrcode.constants.ERROR_CORRECT_L)
        q.add_data(text)
        q.make(fit=True)
        m = q.get_matrix()
    except Exception:
        d.rectangle([x, y, x + size, y + size], outline=BLACK, width=2)
        d.text((x + size / 2, y + size / 2), "QR", font=num(20), fill=BLACK, anchor="mm")
        return
    n = len(m)
    k = max(1, size // n)
    ox, oy = x + (size - n * k) // 2, y + (size - n * k) // 2
    for r, row in enumerate(m):
        for c, v in enumerate(row):
            if v:
                d.rectangle([ox + c * k, oy + r * k, ox + c * k + k - 1, oy + r * k + k - 1], fill=BLACK)


def page_setup(ap, message="", url="http://10.42.0.1"):
    """熱點模式：左邊 QR（掃了就連上熱點），右邊步驟。"""
    from .wifi import wifi_qr_text
    img, d = canvas()
    draw_qr(img, wifi_qr_text(ap["ssid"], ap["password"]), 6, 6, 116)
    x = 128
    msg = message or "請設定 Wi-Fi"
    size = next((z for z in (14, 13, 12, 11) if d.textlength(msg, font=cjk(z, True)) <= W - x - 4), 11)
    d.text((x, 4 + (14 - size)), fit(d, msg, cjk(size, True), W - x - 4), font=cjk(size, True), fill=BLACK)
    d.line([x, 24, W - 6, 24], fill=BLACK)
    steps = ["① 手機相機掃左邊 QR", "② 連上後會自動跳出設定頁", "③ 選 Wi-Fi、輸入密碼"]
    for i, t in enumerate(steps):
        d.text((x, 28 + i * 17), t, font=cjk(12), fill=BLACK)
    d.text((x, 82), "沒跳出來就開", font=cjk(10), fill=BLACK)
    d.text((x + 62, 82), url.replace("http://", ""), font=num(10, False), fill=BLACK)
    for y, label, val in ((96, "熱點", ap["ssid"]), (111, "密碼", ap["password"])):
        d.text((x, y), label, font=cjk(11), fill=BLACK)
        d.text((x + 28, y + 1), val, font=num(11), fill=BLACK)
    return img


def page_connecting(ssid):
    img, d = canvas()
    d.text((W / 2, 46), "正在連線…", font=cjk(22, True), fill=BLACK, anchor="mm")
    d.text((W / 2, 80), fit(d, ssid, cjk(16), W - 20), font=cjk(16), fill=BLACK, anchor="mm")
    return img


def page_connected(ssid, ip="", port=None):
    img, d = canvas()
    d.text((8, 8), "✓ Wi-Fi 已連線", font=cjk(20, True), fill=BLACK)
    d.text((8, 40), fit(d, ssid, cjk(14), W - 16), font=cjk(14), fill=BLACK)
    if ip and port:
        url = f"http://{ip}:{port}"
        draw_qr(img, url, W - 74, 54, 68)
        d.text((8, 72), "設定網頁（同一個 Wi-Fi 下打開）", font=cjk(11), fill=BLACK)
        d.text((8, 90), url, font=num(13), fill=BLACK)
    return img


def page_boot(ip="", port=None):
    img, d = canvas()
    d.text((8, 14), "電子紙看板 啟動中", font=cjk(20, True), fill=BLACK)
    d.text((8, 48), "正在連線取得天氣、台電、股價匯率…", font=cjk(12), fill=BLACK)
    if ip and port:
        d.text((8, 78), "設定網頁", font=cjk(11, True), fill=BLACK)
        d.text((8, 94), f"http://{ip}:{port}", font=num(15), fill=BLACK)
    elif ip:
        d.text((8, 90), f"IP {ip}", font=num(14), fill=BLACK)
    return img
