MichaelEE0318/einkboard/(commit log)

2026-10-30 einkboard: e-paper desk board for Pi Zero 2W
    Three rotating pages on a 2.9" e-paper (clock + weather, Taipower supply,
    TW stocks + FX), night mode, partial refresh, three-tier market fallback
    (MIS -> official close -> disk cache), and support for the 7-pin Heltec
    module without a RST pin.
    Claude-Session: https://claude.ai/code/session_017q85aDhjE7pAPKPWYUFAaG
2026-10-30 Add Heltec 2.9" SSD1680 driver using the panel's built-in waveform
    Waveshare's epd2in9_V2 loads a LUT tuned for Waveshare glass; on the Heltec
    DEPG0290 panel that gave inverted colours, heavy ghosting and broken partial
    refresh. heltec290.py follows Heltec's own init (soft reset, OTP waveform),
    full refresh 0x22=0xF7, partial 0x22=0xFF with 0x26 as the previous image.
    Default driver is now heltec290; eink.invert added as an escape hatch.
    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
    [config.py, display.py, einktest.py, heltec290.py]
2026-10-30 Heltec driver: real partial refresh (GxEPD2 LUT + 0xCC), full refresh only on the hour
    The panel has no usable OTP partial waveform, so 0x22=0xFF fell back to a
    flashing full update. Load GxEPD2_290_BS's partial LUT (0x32) and refresh
    with 0xCC, power off with 0x83 afterwards; reload the LUT after every full
    refresh. full_refresh_every now defaults to 0 (full refresh only at :00).
    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
2026-10-30 Heltec driver: don't cut partial refresh short; print BUSY diagnostics
    BUSY rises a few ms after 0x20; polling immediately saw "idle" and the
    following power-off command aborted the partial update. Wait 20 ms before
    polling and fall back to the datasheet time if BUSY never rises. einktest
    now prints each refresh's duration and whether BUSY toggled.
    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
    [einktest.py, heltec290.py]
2026-10-30 Heltec driver: selectable partial modes + `einktest --modes` to pick one
    Partial refresh with the SSD1680 (S800) LUT ran 3 s with no visible change
    on Michael's panel, which points at the older S75A (SSD1675A) generation.
    Add partial_mode: gx_cc (S800 LUT), otp_c4 (Heltec S75A method: 0x74/0x7E,
    0xB1 load, 0xC4 refresh), otp_ff (built-in mode 2). einktest --modes tries
    each, asks what the panel did, and prints the config line to use.
    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
2026-10-30 Heltec S75A (SSD1675A): 70-byte partial LUT modes to stop the flashing
    otp_c4 works on Michael's panel but uses the built-in full waveform, so it
    flashes. Add lut_cc / lut_c4 / lut_strong: the same partial voltage pattern
    as GxEPD2's, in the 70-byte SSD1675A layout. einktest --modes now tries
    these first and also asks whether the text is crisp.
    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
2026-10-30 Taipower: merge the split records in d006020
    The open-data JSON puts one snapshot into four records (now / today's
    forecast / yesterday / supply capacity); only the first was being read,
    so reserve rate, capacity and the light were blank. Test uses the exact
    response captured on the Pi.
    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
2026-10-30 einktest --ghost: compare 6 partial-waveform strengths / page-change strategies
    Adds lut_tp / lut_rp (partial LUT frames and repeats) and
    page_change_whitewash (old page -> white -> new page) to the config, and a
    guided test that full-refreshes a dense page, partial-switches to another,
    asks for a ghost score and prints the best settings.
    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
2026-10-30 Market: short names for index codes (t00 加權指數, o00 櫃買指數)
    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
    [sources.py]
2026-10-30 Market page: fit % boxes for 4 rows, hide sparkline under 15 min, full refresh after boot
    - Percentage box and font scale with row height; text is vertically centred
    - Sparkline needs at least 15 minutes of history (right after a restart it
    looked like a broken stub)
    - Boot screen -> first page counts as a page change, so the boot text no
    longer ghosts under the first page
    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
    [main.py, pages.py]
2026-10-30 Market page: show the price change (▼1,173) next to the %, auto-fit font
    Option C from the mock-ups: one box per row with the move on the left and
    the percentage on the right. The font is chosen once per page — the largest
    size (11/10/9/8) at which every row fits — so a 4-digit index move shrinks
    all rows together instead of overlapping.
    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
2026-10-30 Settings web page: live controls, preview, status and config editor
    - http://<pi>:8080 (stdlib http.server, no new dependencies); URL shown on
    the boot screen
    - Next / previous / go to page / pause rotation / full refresh / refetch:
    queued to the main loop, which now wakes immediately instead of sleeping
    to the next minute
    - Live preview of the panel image and per-source status with errors
    - Config editor with server-side validation; saves to config.yaml (backup
    in .bak, unedited keys kept) and restarts via exit code 75 so systemd's
    Restart=on-failure brings it back with the new settings
    Claude-Session: https://claude.ai/code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
    [config.py, main.py, pages.py, web.py]
2026-10-30 Status signs: 出差中 / 下班了 / 暫離, held until "回到輪播"
    - Three sign pages (plane / moon / cup icons drawn with primitives):
    trip shows place, return date with a day countdown and contact note;
    off shows "明天/下週一 09:00 見" plus tomorrow's weather; away shows the
    expected return time and minutes away (partial refresh, no flash)
    - A sign overrides rotation and night mode and is saved to
    cache_dir/sign.json so it survives reboots; flipping pages or
    "回到輪播" takes it down
    - Settings page: 狀態牌 card with per-type fields and validation
    Claude-Session: https://claude.ai/code/session_017q85aDhjE7p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
    [main.py, pages.py, web.py]
2026-10-30 Wi-Fi indicator on every page (bars / no internet / disconnected)
    - Reads link quality from /proc/net/wireless (no network traffic), maps it
    to 1-3 bars with hysteresis so a wavering signal doesn't keep redrawing
    - "!" when Wi-Fi is up but no data source has succeeded for 20 minutes;
    a slash when wlan0 isn't associated
    - Top-right header items on each page moved left to make room; clock
    temperature right-aligned at size 32
    - Settings page status card shows the Wi-Fi state too
    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
    [main.py, pages.py, web.py]
2026-10-30 Night window can show the 下班了 sign instead of 晚安
    night.page: night | off, with off_back / off_note for the off sign. Drawn
    once at the start of the window like before; a manual sign still wins.
    Settings page: radio choice plus back time / note fields, validated.
    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
2026-10-30 Weekend all day: night screen from Friday night to Monday morning
    - night.weekend_all_day (default on, checkbox on the settings page): the
    night window covers Fri from its start, all Sat/Sun, Mon until its end
    - During a long night the screen redraws once a day at midnight (one
    flash) so tomorrow's weather and wording stay right; otherwise untouched
    - 下班了 wording: Fri/Sat -> 下週一, Sun -> 明天, weekday small hours -> 今天
    (Sat 02:00 no longer says 今天)
    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
    [config.py, main.py, pages.py, web.py]
2026-11-01 字卡: status-sign layout with built-in or uploaded icon
    - layout=sign: framed like the other signs, icon on the left, text auto-fit on the right
    - 17 built-in icons (meeting, phone, clock, lunch, WFH, car, plane, site helmet, bolt, battery, ...)
    - Upload your own image: shrunk in the browser to 86x112, stored grayscale, rendered as threshold
    (logos) or dithered (photos); picker served from /icon/<key>.png and /api/icons
    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
2026-11-02 Wi-Fi setup: hotspot + phone setup page when no saved Wi-Fi at boot or the password is wrong
    - Boot check: nothing saved -> hotspot now; saved Wi-Fi visible but auth fails 3x -> hotspot now;
    no saved Wi-Fi seen for 150 s -> hotspot. Once connected, outages are left to NetworkManager.
    - E-paper shows a Wi-Fi QR (per-device SSID/password in /var/lib/einkboard/ap.json); any URL on
    the hotspot serves the setup page so phones pop it up (dnsmasq address=/#/10.42.0.1, port 80)
    - Wrong password / not found -> back to hotspot with the reason on panel and page
    - While the hotspot is up and nobody is using the page, re-check saved Wi-Fi every 10 min
    (after a power cut the Pi often boots before th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
    [config.py, main.py, pages.py, wifi.py]
2026-11-02 Wi-Fi boot check: timing logs, tolerant state parsing, nmcli timeouts don't crash
    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
    [main.py, wifi.py]
2026-11-02 Wi-Fi portal: 'nobody used the page' was wrong during the first 3 min after boot
    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
    [wifi.py]
2026-11-02 Saving settings: restart right away and reload only from the new process; one boot screen
    - Restart command now exits the main loop immediately (it used to draw a page and sleep until the
    next minute, so the page re-read the OLD config from the still-running process -> values 'reverted')
    - GET /api/config reads the saved file; save returns the process boot id and the page waits for a
    different one before reloading the form (shows a seconds counter)
    - Power-on with Wi-Fi already up: draw the boot screen once, with the IP (no IP-less screen first)
    - Restart after saving: no boot screen at all, straight back to the content (one full refresh)
    - Wait for first data instead of a fixed sleep; R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
    [main.py, web.py]
2026-11-02 Add 3D-printed case v4.2 (OpenSCAD source + STLs) under CC BY-NC 4.0
    hardware/case/: source .scad (rotation-based print orientation), shell x3 styles, plate,
    e-paper fit test, assembly image, print/assembly README and LICENSE
    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
    [eink_display_v4.scad, eink_fit_test.stl, plate.stl, shell_clean.stl, shell_retro.stl, shell_ribbed.stl]
2026-11-03 Offline: drop the 離線 badge that covered page text; show '!' next to the Wi-Fi icon instead
    Headers keep clear of the widened status corner (temperature, 更新 time, 盤中 badge moved 6 px left).
